yrrapt/reflow-controller/README.md

# reflow-controller
Quick reflow oven controller design
