yrrapt/reflow-controller/hardware/reflow-controller/reflow-controller.kicad_pcb

## KiCad design hardware/reflow-controller/reflow-controller.kicad_pcb (2020-05-31)

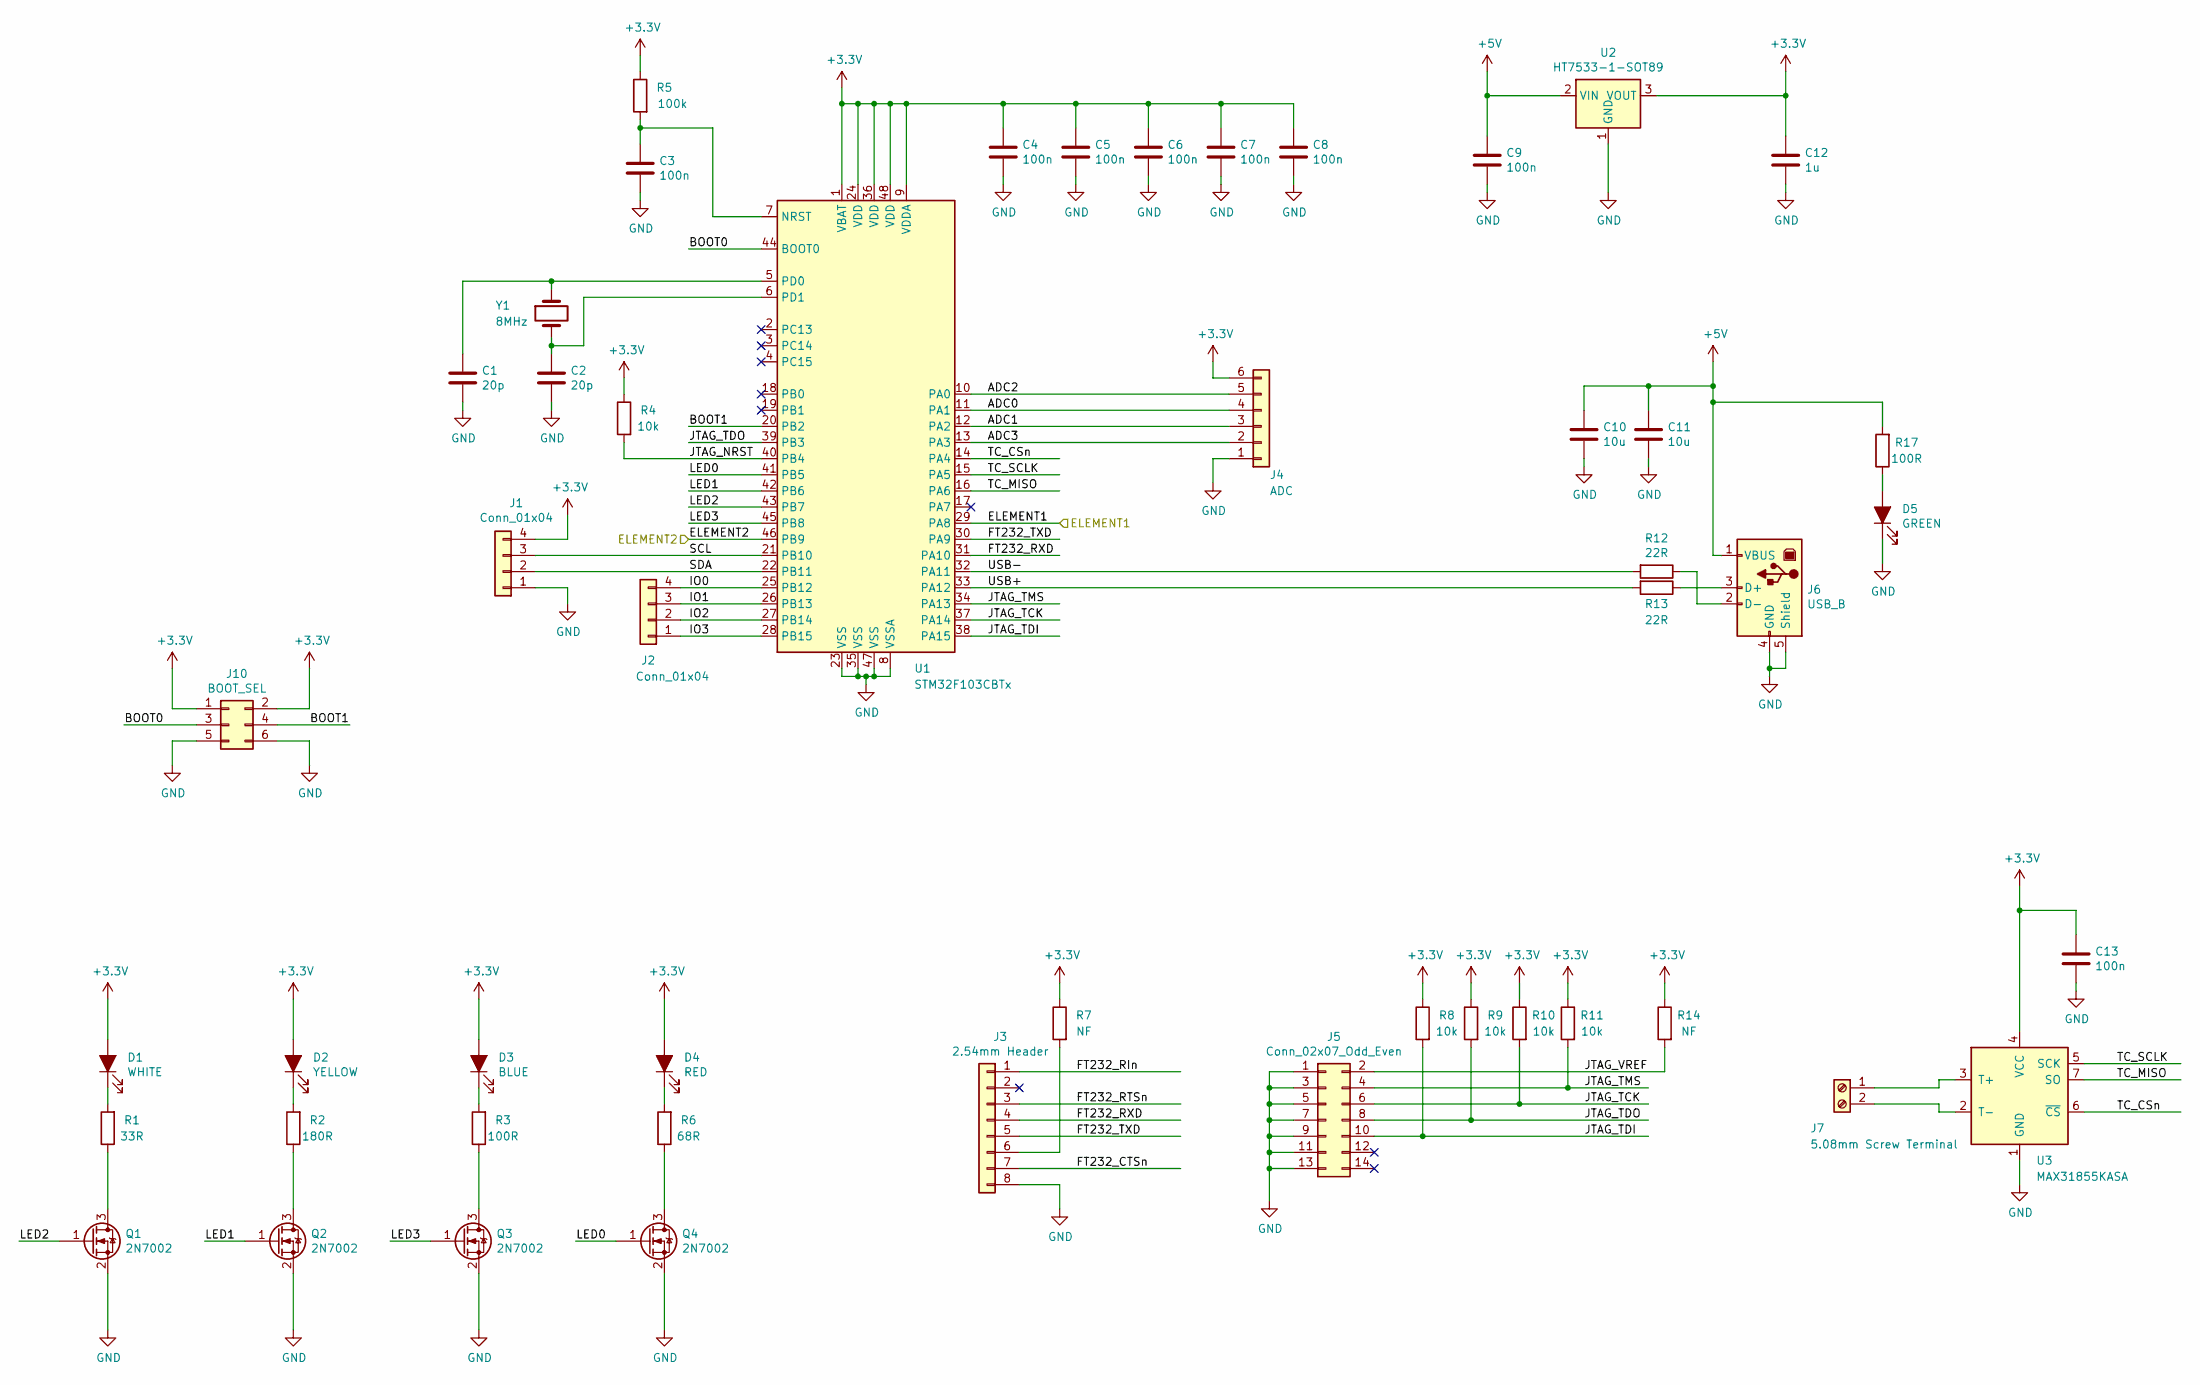
[picture p1: schematic low_voltage.sch]

Parts:
C1, C2: 20p; C_0603_1608Metric; LCSC Part # C1648
C3, C4, C5, C6, C7, C8, C9, C13: 100n; C_0603_1608Metric; LCSC Part # C14663
C10, C11: 10u; C_1206_3216Metric; LCSC Part # C13585
C12: 1u; C_1206_3216Metric; LCSC Part # C1848
D1: WHITE; LED_0603_1608Metric; LCSC Part # C2290
D2: YELLOW; LED_0603_1608Metric; LCSC Part # C72038
D3: BLUE; LED_0603_1608Metric; LCSC Part # C72041
D4: RED; LED_0603_1608Metric; LCSC Part # C2286
D5: GREEN; LED_0603_1608Metric; LCSC Part # C72043
J1, J2: Conn_01x04; PinHeader_1x04_P2.54mm_Vertical
J3: 2.54mm Header; PinHeader_1x08_P2.54mm_Vertical
J4: ADC; PinHeader_1x06_P2.54mm_Vertical
J5: Conn_02x07_Odd_Even; PinHeader_2x07_P2.00mm_Vertical_SMD
J6: USB_B; USB_B_OST_USB-B1HSxx_Horizontal
J7: 5.08mm Screw Terminal; TerminalBlock_bornier-2_P5.08mm
J10: BOOT_SEL; PinSocket_2x03_P2.54mm_Vertical
Q1, Q2, Q3, Q4: 2N7002; SOT-23; LCSC Part # C8545
R1: 33R; R_0603_1608Metric; LCSC Part # C23140
R2: 180R; R_0603_1608Metric; LCSC Part # C22828
R3, R17: 100R; R_0603_1608Metric; LCSC Part # C22775
R4, R8, R9, R10, R11: 10k; R_0603_1608Metric; LCSC Part # C25804
R5: 100k; R_0603_1608Metric; LCSC Part # C25803
R6: 68R; R_0603_1608Metric; LCSC Part # C27592
R7, R14: NF; R_0603_1608Metric
R12, R13: 22R; R_0603_1608Metric; LCSC Part # C23345
U1: STM32F103CBTx; LQFP-48_7x7mm_P0.5mm; LCSC Part # C8304
U2: HT7533-1-SOT89; SOT-89-3; LCSC Part # C14289
U3: MAX31855KASA; SOIC-8_3.9x4.9mm_P1.27mm; LCSC Part # C52028
Y1: 8MHz; Crystal_SMD_5032-2Pin_5.0x3.2mm; LCSC Part # C115962

Connections:
+3V3: C4.1, C5.1, C6.1, C7.1, C8.1, C12.1, C13.1, D1.2 (A), D2.2 (A), D3.2 (A), D4.2 (A), J1.4, J4.6, J10.1, J10.2, R4.1, R5.1, R7.1, R8.1, R9.1, R10.1, R11.1, R14.1, U1.1 (VBAT), U1.9 (VDDA), U1.24 (VDD), U1.36 (VDD), U1.48 (VDD), U2.3 (VOUT), U3.4 (VCC); also elsewhere on the board
+5V: C9.1, C10.1, C11.1, J6.1 (VBUS), R17.2, U2.2 (VIN)
/High Voltage/ELEMENT1: U1.29 (PA8); also elsewhere on the board
/High Voltage/ELEMENT2: U1.46 (PB9); also elsewhere on the board
/Low Voltage/ADC0: J4.4, U1.11 (PA1)
/Low Voltage/ADC1: J4.3, U1.12 (PA2)
/Low Voltage/ADC2: J4.5, U1.10 (PA0)
/Low Voltage/ADC3: J4.2, U1.13 (PA3)
/Low Voltage/BOOT0: J10.3, U1.44 (BOOT0)
/Low Voltage/BOOT1: J10.4, U1.20 (PB2)
/Low Voltage/FT232_CTSn: J3.7
/Low Voltage/FT232_RIn: J3.1
/Low Voltage/FT232_RTSn: J3.3
/Low Voltage/FT232_RXD: J3.4, U1.31 (PA10)
/Low Voltage/FT232_TXD: J3.5, U1.30 (PA9)
/Low Voltage/IO0: J2.4, U1.25 (PB12)
/Low Voltage/IO1: J2.3, U1.26 (PB13)
/Low Voltage/IO2: J2.2, U1.27 (PB14)
/Low Voltage/IO3: J2.1, U1.28 (PB15)
/Low Voltage/JTAG_NRST: R4.2, U1.40 (PB4)
/Low Voltage/JTAG_TCK: J5.6, R10.2, U1.37 (PA14)
/Low Voltage/JTAG_TDI: J5.10, R8.2, U1.38 (PA15)
/Low Voltage/JTAG_TDO: J5.8, R9.2, U1.39 (PB3)
/Low Voltage/JTAG_TMS: J5.4, R11.2, U1.34 (PA13)
/Low Voltage/JTAG_VREF: J5.2, R14.2
/Low Voltage/LED0: Q4.1 (G), U1.41 (PB5)
/Low Voltage/LED1: Q2.1 (G), U1.42 (PB6)
/Low Voltage/LED2: Q1.1 (G), U1.43 (PB7)
/Low Voltage/LED3: Q3.1 (G), U1.45 (PB8)
/Low Voltage/SCL: J1.3, U1.21 (PB10)
/Low Voltage/SDA: J1.2, U1.22 (PB11)
/Low Voltage/TC_CSn: U1.14 (PA4), U3.6 (~CS~)
/Low Voltage/TC_MISO: U1.16 (PA6), U3.7 (SO)
/Low Voltage/TC_SCLK: U1.15 (PA5), U3.5 (SCK)
/Low Voltage/USB+: R13.2, U1.33 (PA12)
/Low Voltage/USB-: R12.2, U1.32 (PA11)
GND: C1.2, C2.2, C3.2, C4.2, C5.2, C6.2, C7.2, C8.2, C9.2, C10.2, C11.2, C12.2, C13.2, D5.1 (K), J1.1, J3.8, J4.1, J5.1, J5.3, J5.5, J5.7, J5.9, J5.11, J5.13, J6.4 (GND), J6.5 (Shield), J10.5, J10.6, Q1.2 (S), Q2.2 (S), Q3.2 (S), Q4.2 (S), U1.8 (VSSA), U1.23 (VSS), U1.35 (VSS), U1.47 (VSS), U2.1 (GND), U3.1 (GND); also elsewhere on the board
unnamed: C1.1, U1.5 (PD0), Y1.1
unnamed: C2.1, U1.6 (PD1), Y1.2
unnamed: C3.1, R5.2, U1.7 (NRST)
unnamed: D1.1 (K), R1.2
unnamed: D2.1 (K), R2.2
unnamed: D3.1 (K), R3.2
unnamed: D4.1 (K), R6.2
unnamed: D5.2 (A), R17.1
unnamed: J3.6, R7.2
unnamed: J6.2 (D-), R12.1
unnamed: J6.3 (D+), R13.1
unnamed: J7.1, U3.3 (T+)
unnamed: J7.2, U3.2 (T-)
unnamed: Q1.3 (D), R1.1
unnamed: Q2.3 (D), R2.1
unnamed: Q3.3 (D), R3.1
unnamed: Q4.3 (D), R6.1

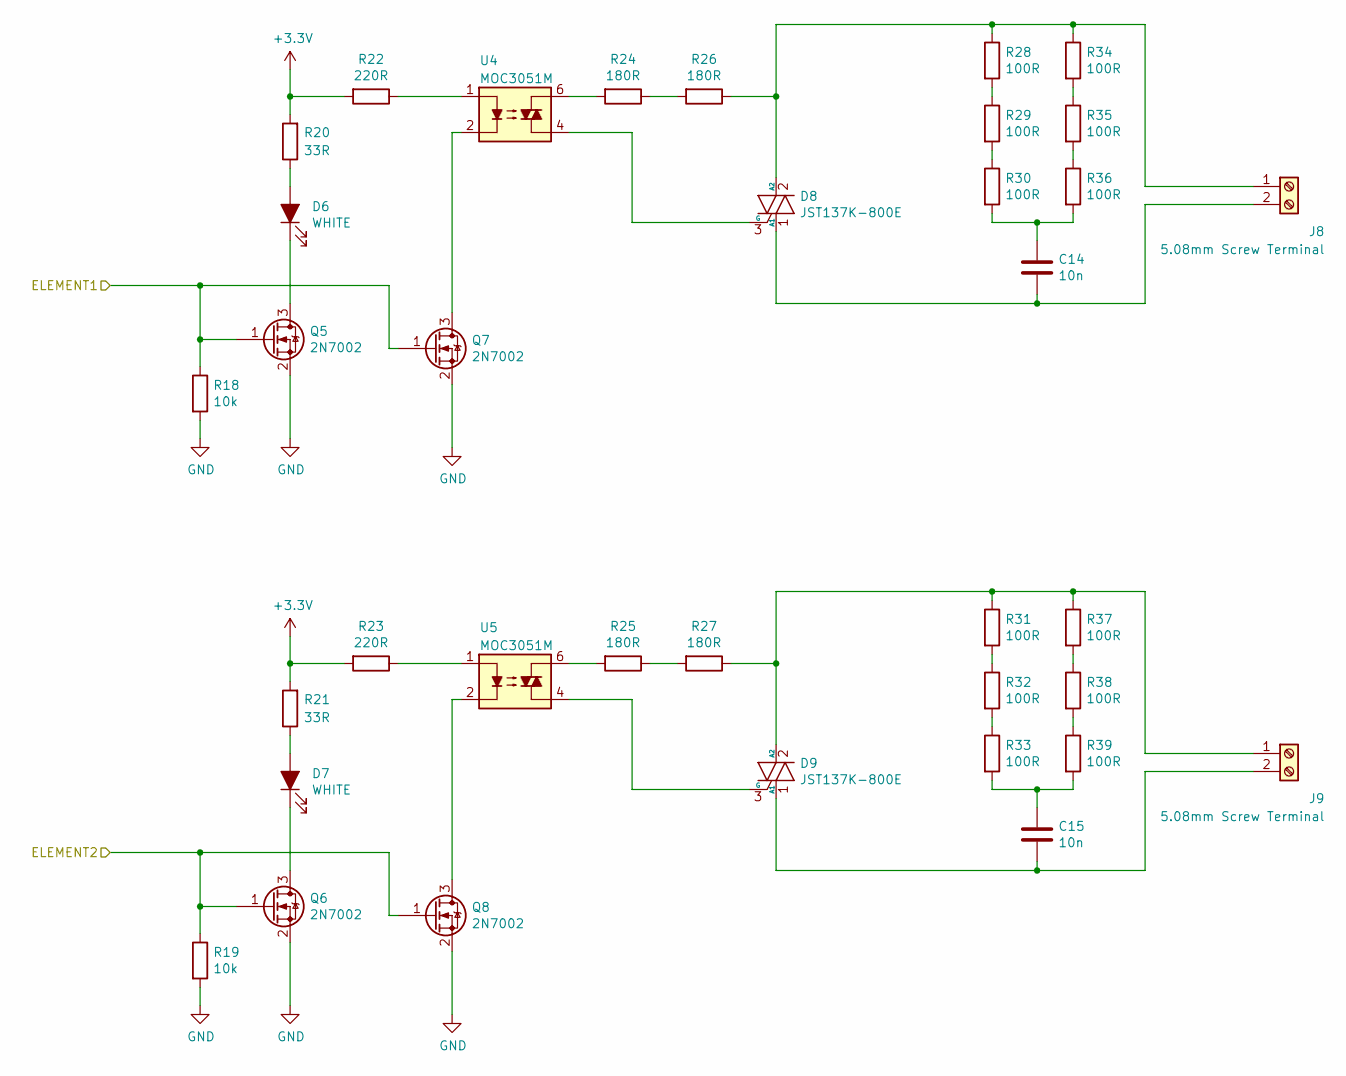
[picture p2: schematic high-voltage.sch]

Parts:
C14, C15: 10n; C_0603_1608Metric; LCSC Part # C57112
D6, D7: WHITE; LED_0603_1608Metric; LCSC Part # C2290
D8, D9: JST137K-800E; TO-252-2; LCSC Part # C179477
J8, J9: 5.08mm Screw Terminal; TerminalBlock_bornier-2_P5.08mm
Q5, Q6, Q7, Q8: 2N7002; SOT-23; LCSC Part # C8545
R18, R19: 10k; R_0603_1608Metric; LCSC Part # C25804
R20, R21: 33R; R_0603_1608Metric; LCSC Part # C23140
R22, R23: 220R; R_0603_1608Metric; LCSC Part # C22962
R24, R25, R26, R27: 180R; R_1206_3216Metric; LCSC Part # C17924
R28, R29, R30, R31, R32, R33, R34, R35, R36, R37, R38, R39: 100R; R_1206_3216Metric; LCSC Part # C17901
U4, U5: MOC3051M; DIP-6_W8.89mm_SMDSocket_LongPads; LCSC Part # C184543

Connections:
+3V3: R20.2, R21.2, R22.2, R23.2; also elsewhere on the board
/High Voltage/ELEMENT1: Q5.1 (G), Q7.1 (G), R18.1; also elsewhere on the board
/High Voltage/ELEMENT2: Q6.1 (G), Q8.1 (G), R19.1; also elsewhere on the board
GND: Q5.2 (S), Q6.2 (S), Q7.2 (S), Q8.2 (S), R18.2, R19.2; also elsewhere on the board
unnamed: C14.1, R30.2, R36.2
unnamed: C14.2, D8.1 (A1), J8.2
unnamed: C15.1, R33.2, R39.2
unnamed: C15.2, D9.1 (A1), J9.2
unnamed: D6.1 (K), Q5.3 (D)
unnamed: D6.2 (A), R20.1
unnamed: D7.1 (K), Q6.3 (D)
unnamed: D7.2 (A), R21.1
unnamed: D8.2 (A2), J8.1, R26.1, R28.1, R34.1
unnamed: D8.3 (G), U4.4
unnamed: D9.2 (A2), J9.1, R27.1, R31.1, R37.1
unnamed: D9.3 (G), U5.4
unnamed: Q7.3 (D), U4.2
unnamed: Q8.3 (D), U5.2
unnamed: R22.1, U4.1
unnamed: R23.1, U5.1
unnamed: R24.1, R26.2
unnamed: R24.2, U4.6
unnamed: R25.1, R27.2
unnamed: R25.2, U5.6
unnamed: R28.2, R29.1
unnamed: R29.2, R30.1
unnamed: R31.2, R32.1
unnamed: R32.2, R33.1
unnamed: R34.2, R35.1
unnamed: R35.2, R36.1
unnamed: R37.2, R38.1
unnamed: R38.2, R39.1

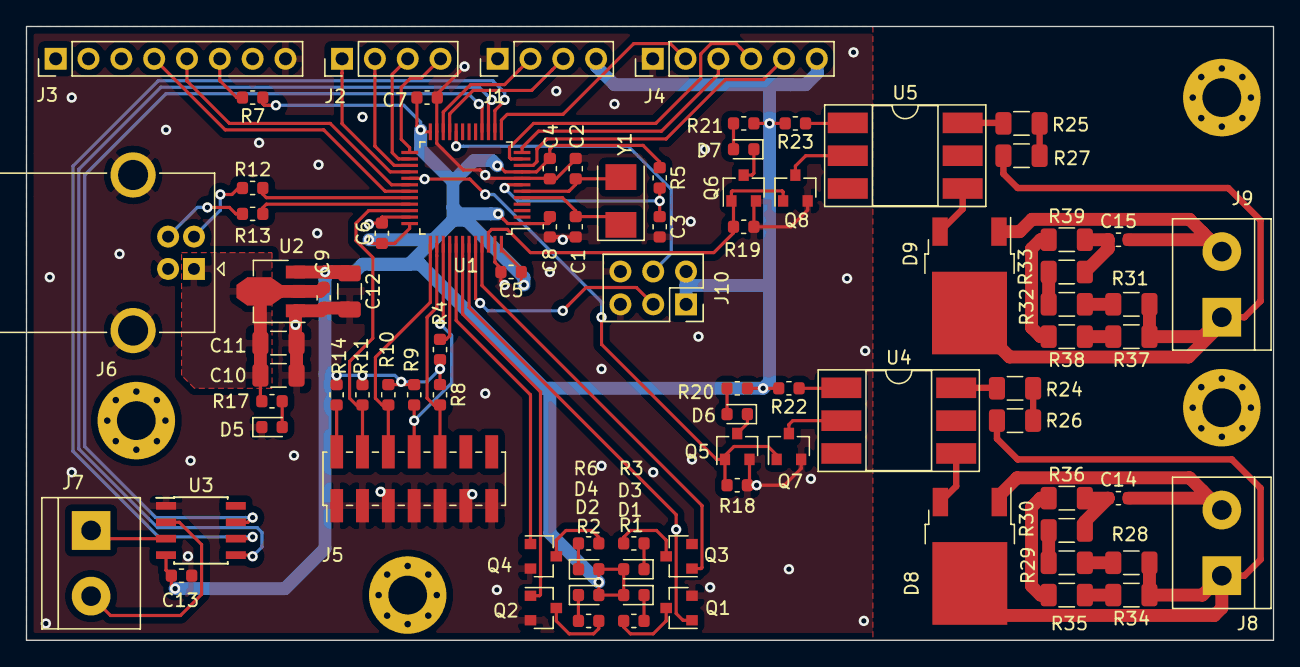
[picture p3: board reflow-controller.kicad_pcb from above]

Board: 2 copper layers, 96.5 x 47.5 mm, 85 parts (0 on the bottom side), 79 nets.
