yrrapt/reflow-controller/(commit log)

2020-05-01 PCB complete and ordered
    [high-voltage.sch, low_voltage.sch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]
2020-05-31 Fixed error with shorting 5V and GND
    [reflow-controller.kicad_pcb]
2020-06-09 Working implementation of turning the oven on and off by software
    [reflow_controller.yaml]
2020-06-13 Restructed project by putting board into local folder and building directly rather than sym-linking to Zephyr install. Moved thermocouple to driver module
    [reflow_controller.yaml]
